smartinezc/Tweepr/Img/Tweepr 2.jpg

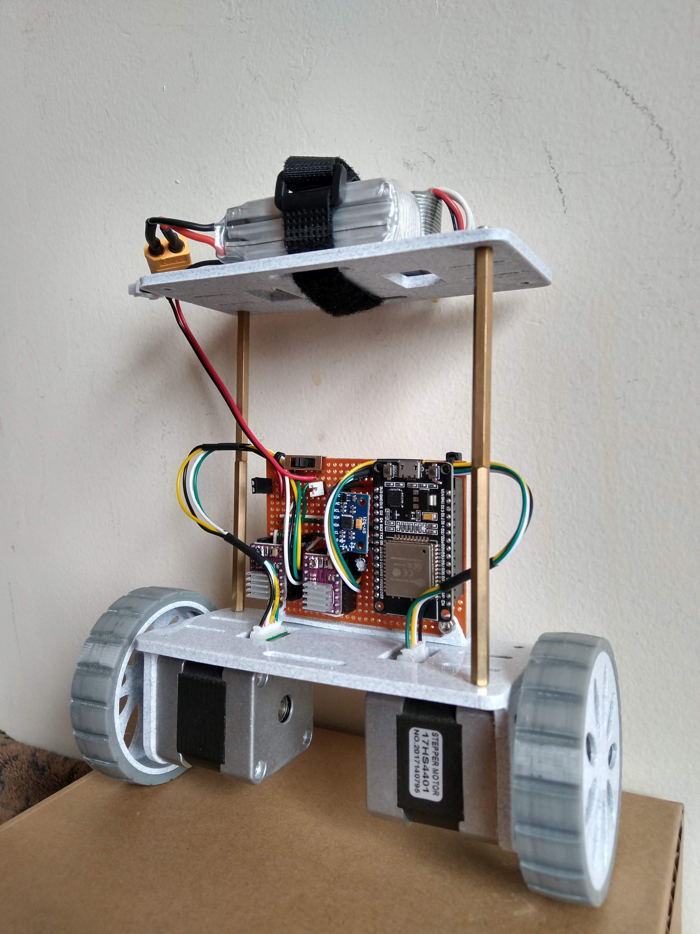
Img/Tweepr 2.jpg
