smartinezc/Tweepr/Img/Tweepr.jpg

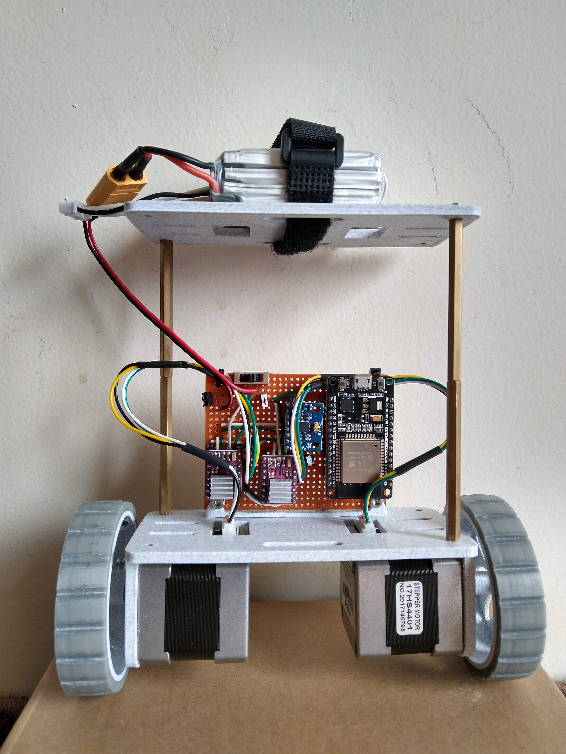
Img/Tweepr.jpg
