smartinezc/Tweepr/README.md

# Tweepr
Two Wheel Electronic Educational Platform for Robotics (TWEEPR) is a low-cost system to teach Engineering and Robotics
