smartinezc/Tweepr/2- Project Proposal/Pendiente Normal/Respaldo.docx

Bogotá, noviembre 30 de 2021

Señores

DEPARTAMENTO DE INGENIERÍA ELÉCTRICA Y ELECTRÓNICA

Universidad de Los Andes

Asunto: Respaldo de solicitud de Pendiente Normal

Apreciado Consejo de Facultad:

En relación con la solicitud de pendiente normal del estudiante Santiago Martínez con código 201612223, y dadas las circunstancias por él descritas, considero conveniente respaldarla.

Atentamente,

FERNANDO JIMÉNEZ VARGAS

Asesor del proyecto
