smartinezc/Tweepr/Img/PID Controller.png

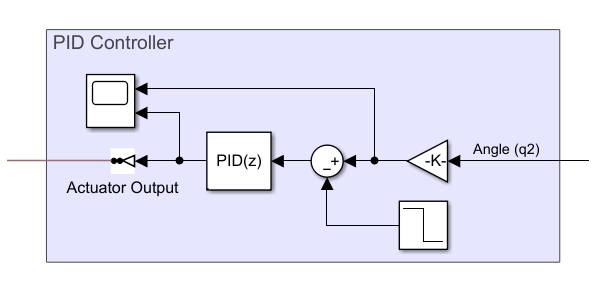
Img/PID Controller.png
