smartinezc/Tweepr/Img/Simulink Simulation.PNG

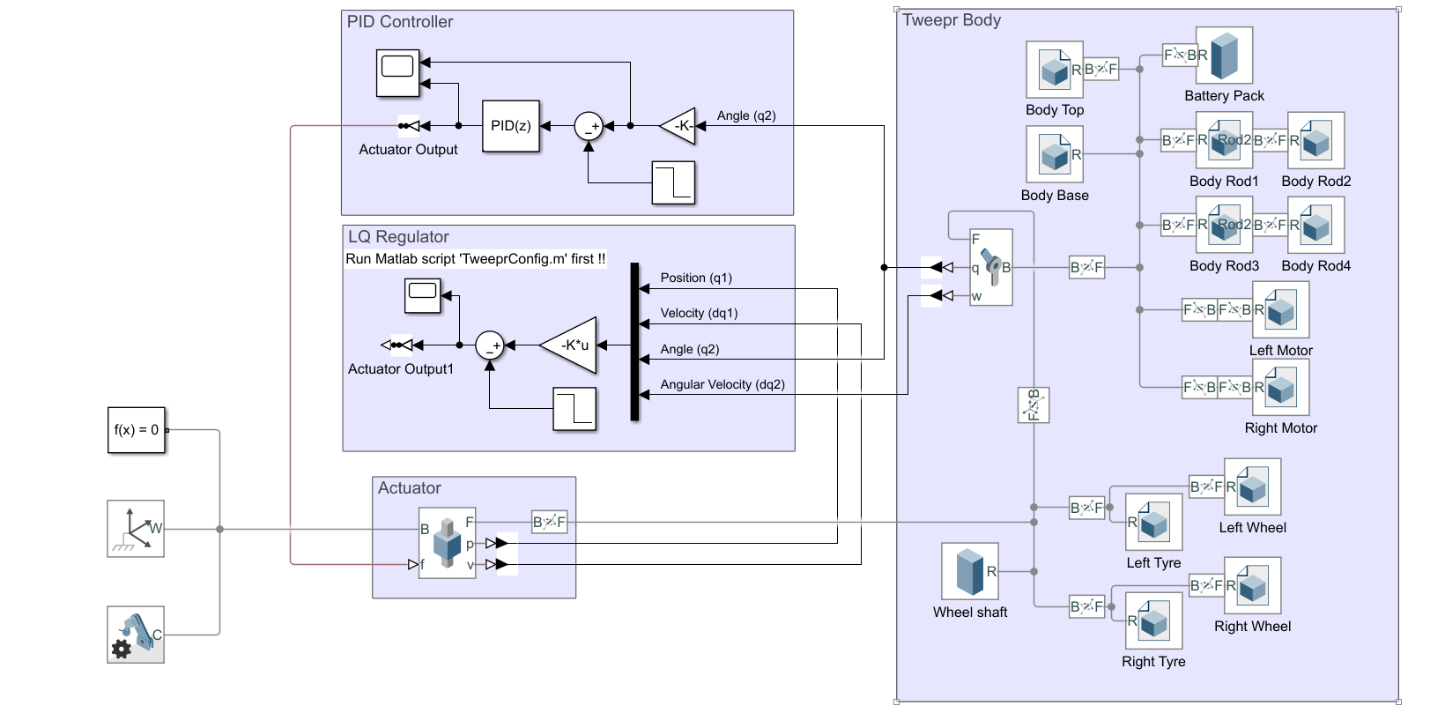
Img/Simulink Simulation.PNG
