smartinezc/Tweepr/Img/Tweepr Design 1.jpeg

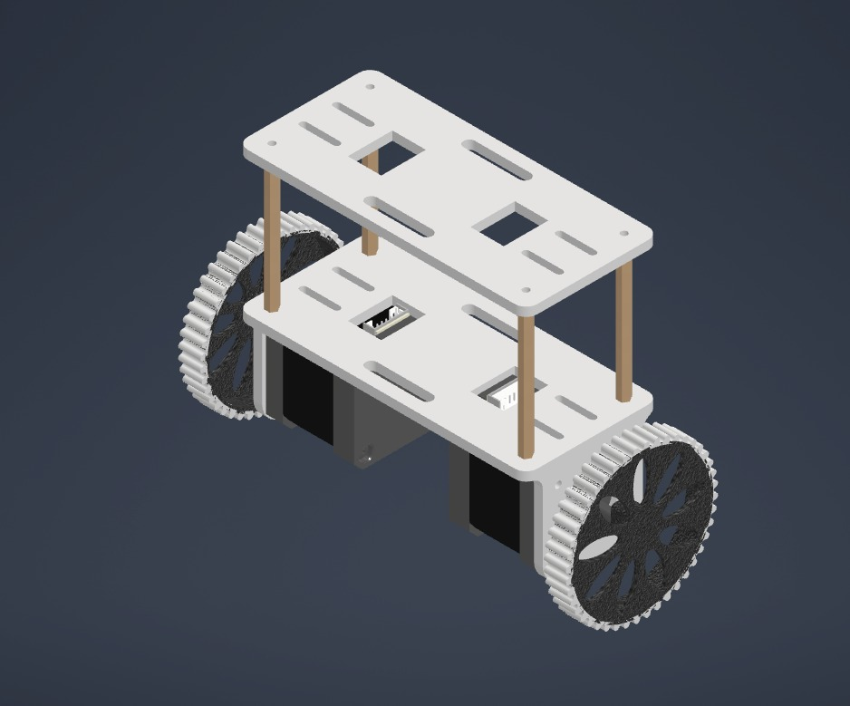
Img/Tweepr Design 1.jpeg
