smartinezc/Tweepr/3- CAD/Standart Parts/Stepper 17HS4401.stl

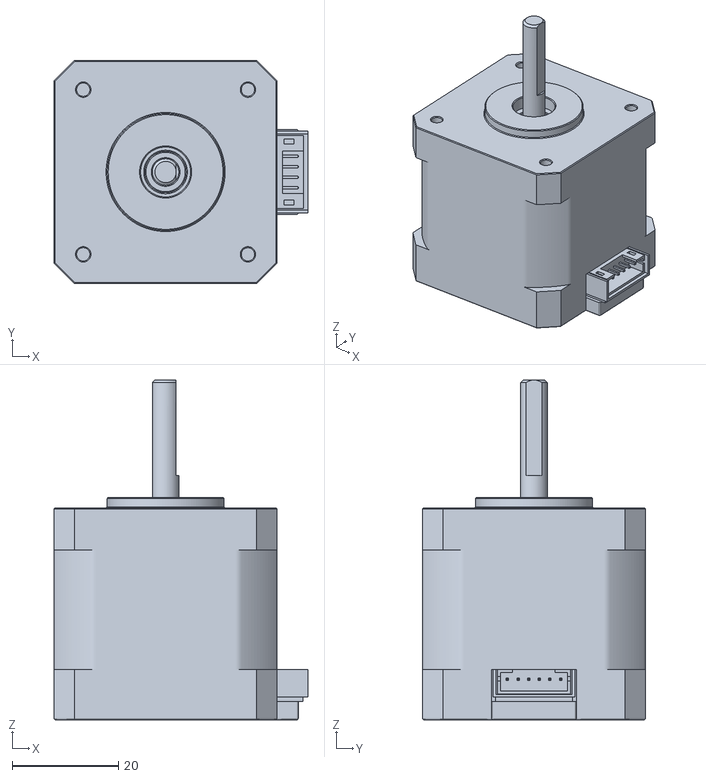
[picture p81: CAD file, 2022-01-12]
3- CAD/Standart Parts/Stepper 17HS4401.stl
47.8 x 42.0 x 64.0
