smartinezc/Tweepr/3- CAD/STL/Brass Spacer.stl

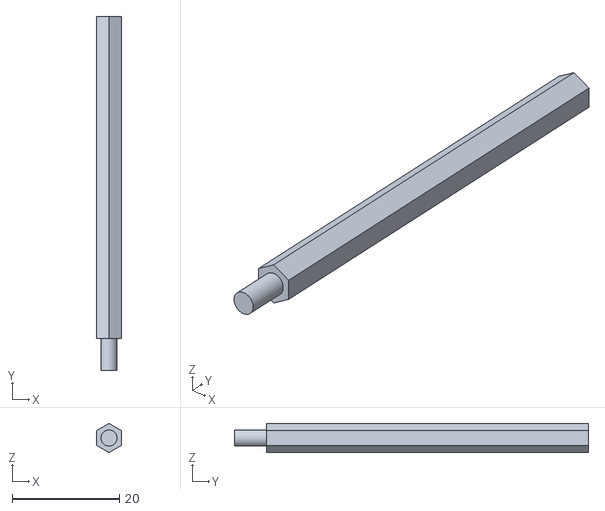
[picture p82: CAD file, 2022-01-12]
3- CAD/STL/Brass Spacer.stl
4.70 x 66.0 x 5.43
