smartinezc/Tweepr/3- CAD/STL/Wheel Outer thick.stl

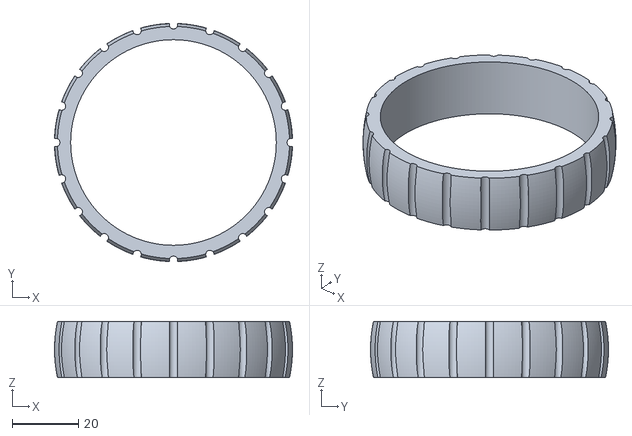
[picture p83: CAD file, 2022-01-07]
3- CAD/STL/Wheel Outer thick.stl
71.8 x 71.8 x 17.0
