smartinezc/Tweepr/3- CAD/STL/PCB Mount Support.stl

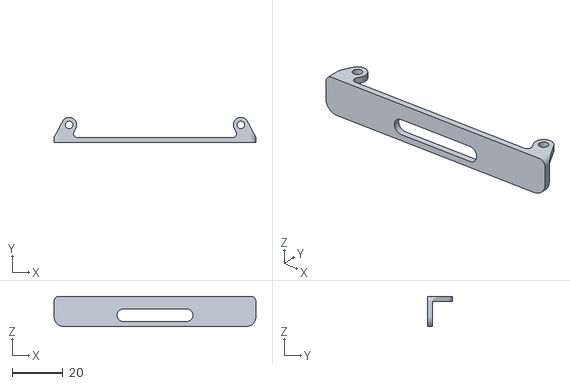
[picture p84: CAD file, 2022-01-06]
3- CAD/STL/PCB Mount Support.stl
80.0 x 10.00 x 12.0
