smartinezc/Tweepr/3- CAD/STL/Base.stl

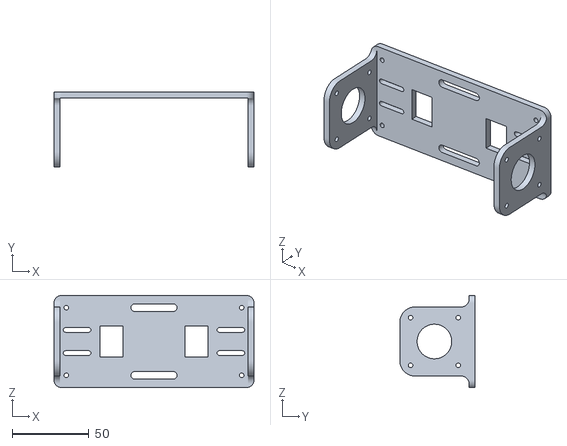
[picture p85: CAD file, 2021-12-28]
3- CAD/STL/Base.stl
130.0 x 49.0 x 60.0
