smartinezc/Tweepr/3- CAD/STL/Wheel Outer.stl

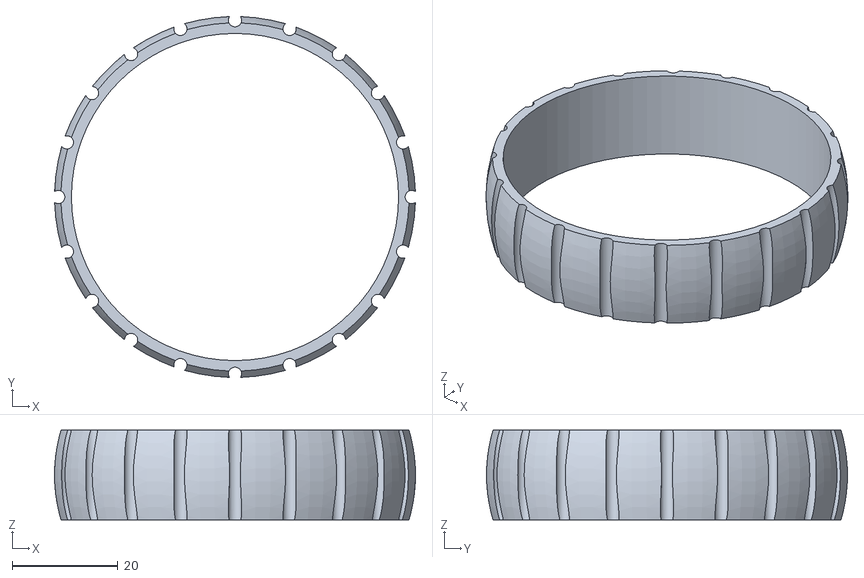
[picture p86: CAD file, 2021-12-28]
3- CAD/STL/Wheel Outer.stl
68.4 x 68.4 x 17.0
