smartinezc/Tweepr/3- CAD/STL/Wheel Inside.stl

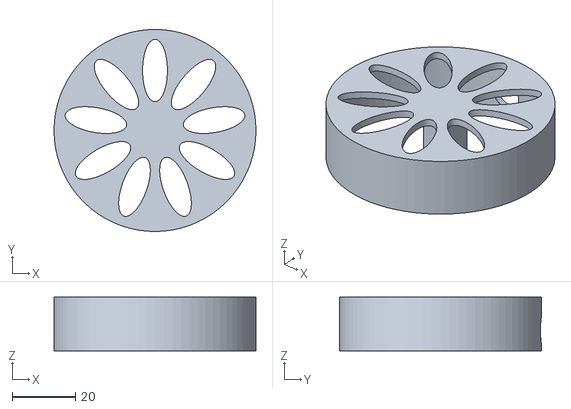
[picture p87: CAD file, 2021-12-28]
3- CAD/STL/Wheel Inside.stl
64.0 x 64.0 x 17.0
