smartinezc/Tweepr/3- CAD/STL/Top.stl

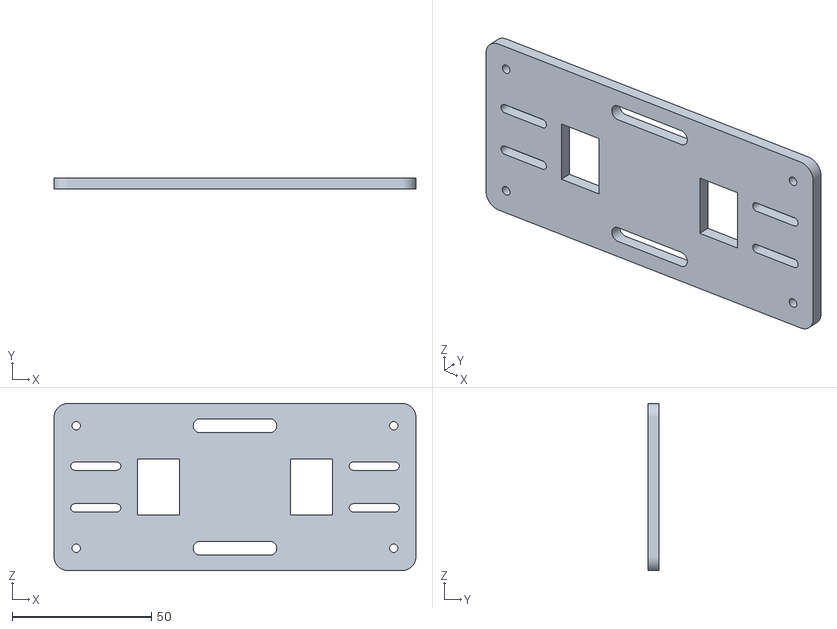
[picture p88: CAD file, 2021-12-28]
3- CAD/STL/Top.stl
130.0 x 4.00 x 60.0
