smartinezc/Tweepr/(list of files, cad)

Other CAD files:
3- CAD/Standart Parts/17HS4401 Nema 17 Stepper.step
3- CAD/Base.ipt
3- CAD/Brass Spacer.ipt
3- CAD/OldVersions/Base.0013.ipt
3- CAD/OldVersions/Brass Spacer.0005.ipt
3- CAD/OldVersions/Top.0001.ipt
3- CAD/OldVersions/Top.0002.ipt
3- CAD/OldVersions/Tweepr.0013.iam
3- CAD/OldVersions/Wheel Inside.0006.ipt
3- CAD/OldVersions/Wheel Outer.0011.ipt
3- CAD/PCB Mount Support.ipt
3- CAD/Standart Parts/Nema 17 Stepper (17HS4401)17HS4401 Nema 17 Stepper.iam
3- CAD/Standart Parts/Nema 17 Stepper (17HS4401)Axis&Rotor.ipt
3- CAD/Standart Parts/Nema 17 Stepper (17HS4401)BallBearing1.ipt
3- CAD/Standart Parts/Nema 17 Stepper (17HS4401)BallBearing2.ipt
3- CAD/Standart Parts/Nema 17 Stepper (17HS4401)Baseplate.ipt
3- CAD/Standart Parts/Nema 17 Stepper (17HS4401)ConnectorPins.iam
3- CAD/Standart Parts/Nema 17 Stepper (17HS4401)ConnectrorBody.ipt
3- CAD/Standart Parts/Nema 17 Stepper (17HS4401)Frontplate.ipt
3- CAD/Standart Parts/Nema 17 Stepper (17HS4401)Insulation.ipt
3- CAD/Standart Parts/Nema 17 Stepper (17HS4401)M3x30-Screw_001.ipt
3- CAD/Standart Parts/Nema 17 Stepper (17HS4401)M3x30-Screw_002.ipt
3- CAD/Standart Parts/Nema 17 Stepper (17HS4401)M3x30-Screw_003.ipt
3- CAD/Standart Parts/Nema 17 Stepper (17HS4401)M3x30-Screw_004.ipt
3- CAD/Standart Parts/Nema 17 Stepper (17HS4401)PCB.ipt
3- CAD/Standart Parts/Nema 17 Stepper (17HS4401)SOLID.ipt
3- CAD/Standart Parts/Nema 17 Stepper (17HS4401)SOLID001.ipt
3- CAD/Standart Parts/Nema 17 Stepper (17HS4401)SOLID002.ipt
3- CAD/Standart Parts/Nema 17 Stepper (17HS4401)SOLID003.ipt
3- CAD/Standart Parts/Nema 17 Stepper (17HS4401)SOLID004.ipt
3- CAD/Standart Parts/Nema 17 Stepper (17HS4401)SOLID005.ipt
3- CAD/Standart Parts/Nema 17 Stepper (17HS4401)Screws.iam
3- CAD/Standart Parts/Nema 17 Stepper (17HS4401)Stator.ipt
3- CAD/Standart Parts/OldVersions/Nema 17 Stepper (17HS4401)17HS4401 Nema 17 Stepper.0002.iam
3- CAD/Standart Parts/OldVersions/Nema 17 Stepper (17HS4401)Screws.0001.iam
3- CAD/Top.ipt
3- CAD/Tweepr.iam
3- CAD/Wheel Inside.ipt
3- CAD/Wheel Outer.ipt
