smartinezc/Tweepr/(commit log)

2021-12-28 Init
    Import all files to repo
    [17HS4401 Nema 17 Stepper.step, Base.0013.ipt, Base.ipt, Base.stl, Brass Spacer.0005.ipt, Brass Spacer.ipt, Nema 17 Stepper (17HS4401)17HS4401 Nema 17 Stepper.0001.iam, Nema 17 Stepper (17HS4401)17HS4401 Nema 17 Stepper.iam]
2022-01-04 Determine pulse period for Motor Control
2022-01-05 Motor step control routine loop
2022-01-06 Bug fix: Motor pulses always negative
    [tweeprControlLite.ino]
2022-01-06 Create a PCB mount support to fix electronics inside Tweepr
    [PCB Mount Support.ipt, PCB Mount Support.stl]
2022-01-06 Motor Control code implemented
2022-01-07 Implement Timer Interrupt for Motor Control Loop
2022-01-07 Adjusted motor direction, inverse for opposite motors
2022-01-07 Dead band to disable motor control
2022-01-07 Disable motors if error is too high
    [tweeprControlLite.ino]
2022-01-07 Improve Motor Control loop time
2022-01-07 Improve Wheel grip to the surface
    [Wheel Outer thick.stl, Wheel Outer.0010.ipt, Wheel Outer.0011.ipt, Wheel Outer.ipt]
2022-01-09 Web app to change PID Gain values while Tweepr is runnig
2022-01-10 Simulation model for Simulink
    [Brass Spacer.stl, Nema 17 Stepper (17HS4401)17HS4401 Nema 17 Stepper.0001.iam, Nema 17 Stepper (17HS4401)17HS4401 Nema 17 Stepper.0002.iam, Nema 17 Stepper (17HS4401)17HS4401 Nema 17 Stepper.iam, Stepper 17HS4401.stl]
2022-01-10 PID Simulation
2022-01-12 PID simulation completed
2022-01-12 Images and videos of PID simulation
2022-01-13 Final report completed
    [Tweepr.0012.iam, Tweepr.0013.iam, Tweepr.iam]
